rblaze/mbed-turret/board/turret.kicad_pcb

## KiCad design board/turret.kicad_pcb (2022-04-12)

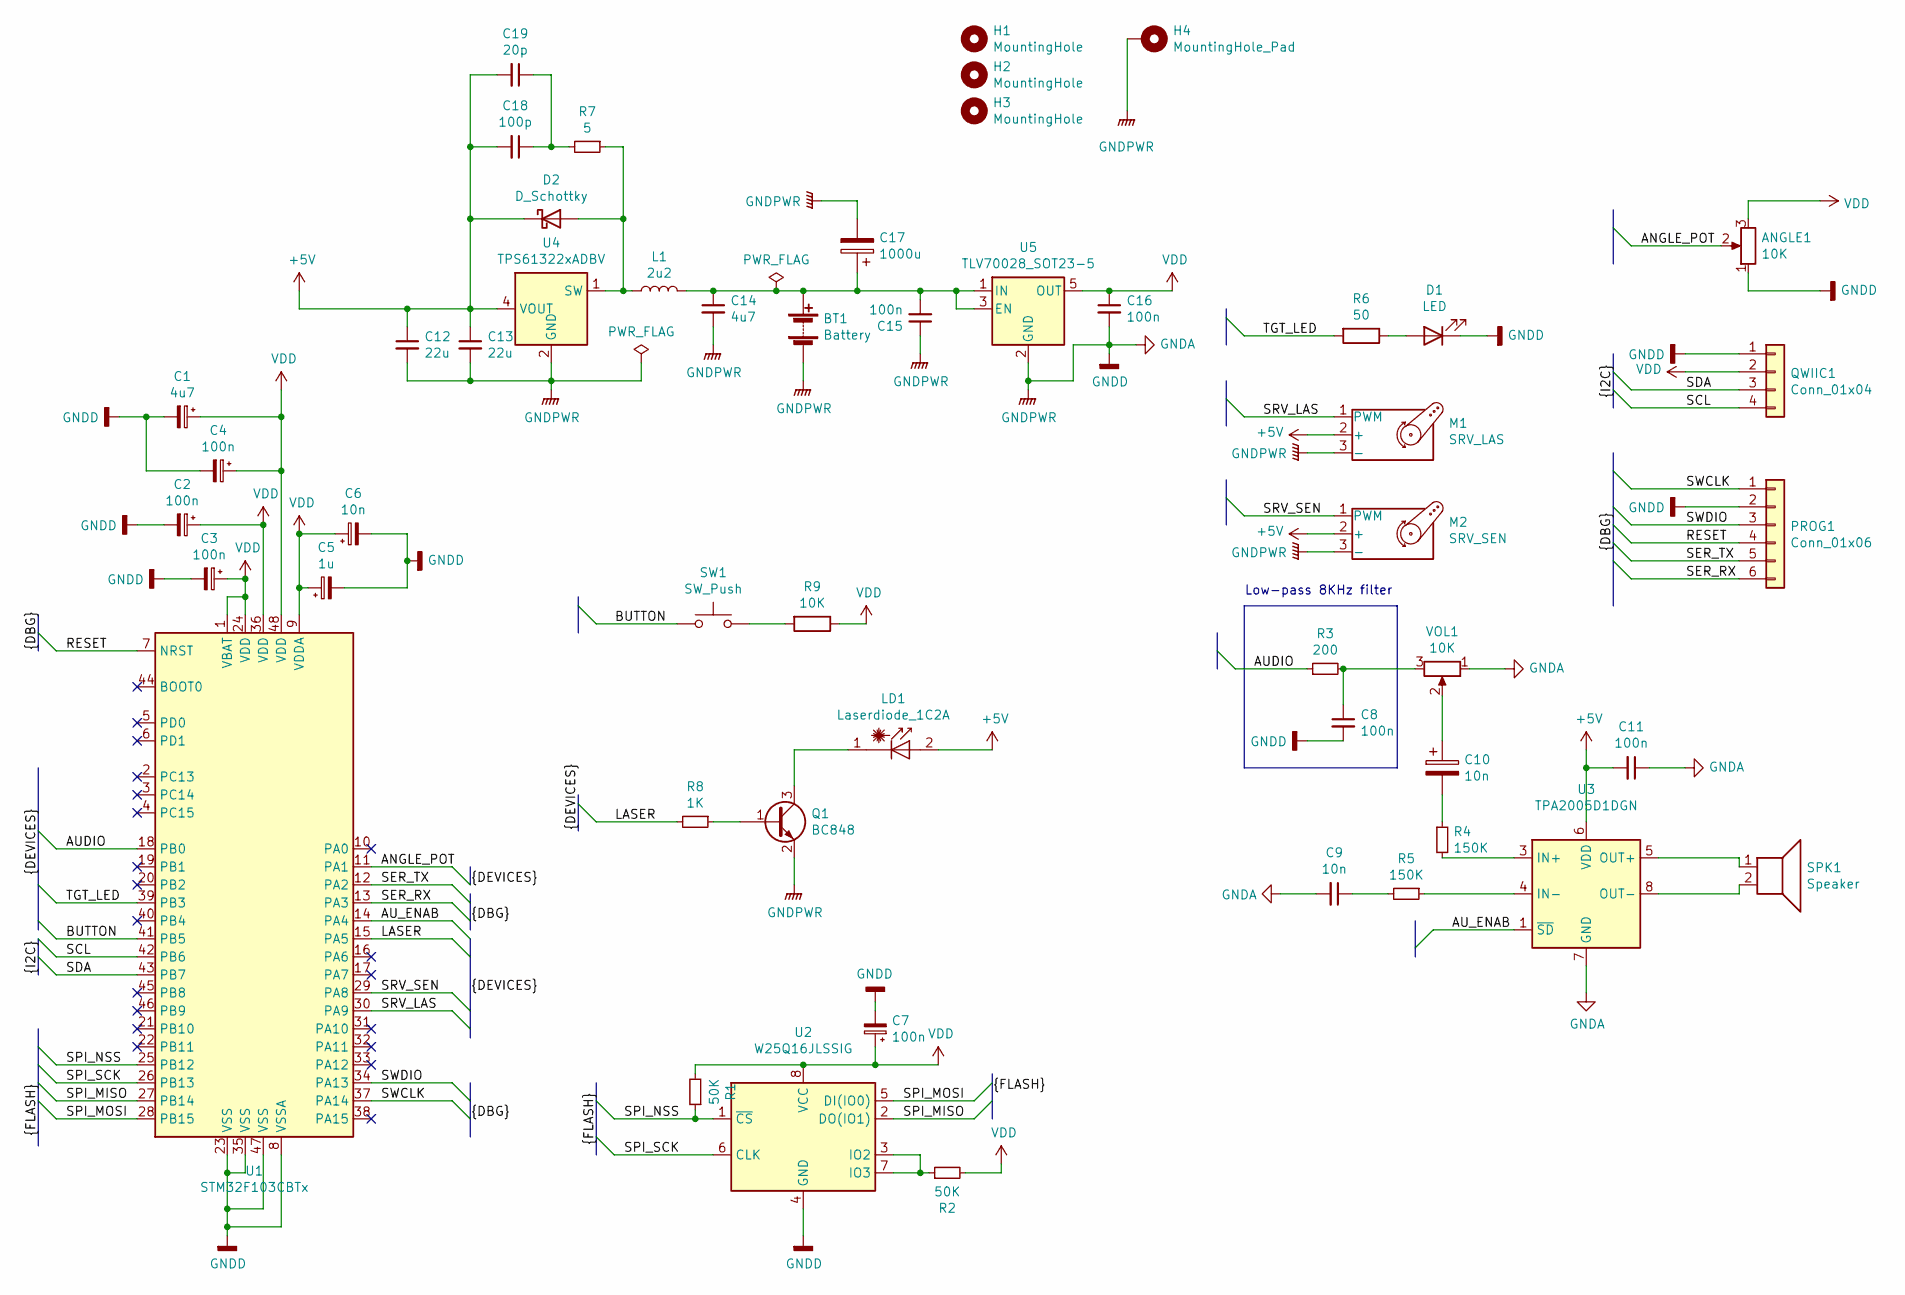
[picture p1: schematic turret.kicad_sch]

Parts:
ANGLE1: 10K; Molex_KK-254_AE-6410-03A_1x03_P2.54mm_Vertical
BT1: Battery; Molex_KK-254_AE-6410-02A_1x02_P2.54mm_Vertical
C1, C14: 4u7; C_0402_1005Metric
C2, C3, C4, C7, C8, C11, C15, C16: 100n; C_0402_1005Metric
C5: 1u; C_0402_1005Metric
C6, C9, C10: 10n; C_0402_1005Metric
C12, C13: 22u; C_0603_1608Metric
C17: 1000u; CP_Radial_D10.0mm_P5.00mm
C18: 100p; C_0402_1005Metric
C19: 20p; C_0402_1005Metric
D1: LED; LED_0805_2012Metric
D2: D_Schottky; D_SOD-323
H1, H2, H3: MountingHole; JLCPCB_Tooling_Hole
H4: MountingHole_Pad; MountingHole_2.2mm_M2_DIN965_Pad
L1: 2u2; L_1008_2520Metric
LD1: Laserdiode_1C2A; Molex_KK-254_AE-6410-02A_1x02_P2.54mm_Vertical
M1: SRV_LAS; Molex_KK-254_AE-6410-03A_1x03_P2.54mm_Vertical
M2: SRV_SEN; Molex_KK-254_AE-6410-03A_1x03_P2.54mm_Vertical
PROG1: Conn_01x06; Molex_SPOX_5267-06A_1x06_P2.50mm_Vertical
Q1: BC848; SOT-23
QWIIC1: Conn_01x04; JST_SH_BM04B-SRSS-TB_1x04-1MP_P1.00mm_Vertical
R1, R2: 50K; R_0402_1005Metric
R3: 200; R_0402_1005Metric
R4, R5: 150K; R_0402_1005Metric
R6: 50; R_0402_1005Metric
R7: 5; R_0402_1005Metric
R8: 1K; R_0402_1005Metric
R9: 10K; R_0402_1005Metric
SPK1: Speaker; Molex_KK-254_AE-6410-02A_1x02_P2.54mm_Vertical
SW1: SW_Push; SW_SPST_PTS810
U1: STM32F103CBTx; LQFP-48_7x7mm_P0.5mm
U2: W25Q16JLSSIG; SOIC-8_5.23x5.23mm_P1.27mm
U3: TPA2005D1DGN; TI_VSSOP-PowerPAD-8_3.0x3.0mm_P0.65mm_ThermalVias
U4: TPS61322xADBV; SOT-23-5
U5: TLV70028_SOT23-5; SOT-23-5
VOL1: 10K; Molex_KK-254_AE-6410-03A_1x03_P2.54mm_Vertical

Connections:
+5V: C11.2, C12.1, C13.1, C18.2, C19.2, D2.1 (K), LD1.2 (A), M1.2 (+), M2.2 (+), U3.6 (VDD), U4.3 (NC), U4.4 (VOUT)
/ANGLE_POT: ANGLE1.2, U1.11 (PA1)
/AUDIO: R3.1, U1.18 (PB0)
/AU_ENAB: U1.14 (PA4), U3.1 (~SD)
/BUTTON: SW1.1, U1.41 (PB5)
/LASER: R8.2, U1.15 (PA5)
/RESET: PROG1.4, U1.7 (NRST)
/SCL: QWIIC1.4, U1.42 (PB6)
/SDA: QWIIC1.3, U1.43 (PB7)
/SER_RX: PROG1.6, U1.13 (PA3)
/SER_TX: PROG1.5, U1.12 (PA2)
/SPI_MISO: U1.27 (PB14), U2.2 (DO(IO1))
/SPI_MOSI: U1.28 (PB15), U2.5 (DI(IO0))
/SPI_NSS: R1.1, U1.25 (PB12), U2.1 (~CS)
/SPI_SCK: U1.26 (PB13), U2.6 (CLK)
/SRV_LAS: M1.1 (PWM), U1.30 (PA9)
/SRV_SEN: M2.1 (PWM), U1.29 (PA8)
/SWCLK: PROG1.1, U1.37 (PA14)
/SWDIO: PROG1.3, U1.34 (PA13)
/TGT_LED: R6.2, U1.39 (PB3)
GNDA: ANGLE1.1, BT1.2 (-), C1.2, C2.2, C3.2, C4.2, C5.2, C6.2, C7.2, C8.2, C9.2, C11.1, C12.2, C13.2, C14.2, C15.1, C16.2, C17.2, D1.1 (K), H4.1, M1.3 (-), M2.3 (-), PROG1.2, Q1.2 (E), QWIIC1.1, U1.8 (VSSA), U1.23 (VSS), U1.35 (VSS), U1.47 (VSS), U2.4 (GND), U3.7 (GND), U3.9, U4.2 (GND), U4.5 (NC), U5.2 (GND), U5.4 (NC), VOL1.1
unnamed: BT1.1 (+), C14.1, C15.2, C17.1, L1.2, U5.1 (IN), U5.3 (EN)
unnamed: C8.1, R3.2, VOL1.3
unnamed: C9.1, R5.2
unnamed: C10.1, VOL1.2
unnamed: C10.2, R4.1
unnamed: C18.1, C19.1, R7.2
unnamed: D1.2 (A), R6.1
unnamed: D2.2 (A), L1.1, R7.1, U4.1 (SW)
unnamed: LD1.1 (K), Q1.3 (C)
unnamed: Q1.1 (B), R8.1
unnamed: R2.1, U2.3 (IO2), U2.7 (IO3)
unnamed: R4.2, U3.3 (IN+)
unnamed: R5.1, U3.4 (IN-)
unnamed: R9.2, SW1.2
unnamed: SPK1.1, U3.5 (OUT+)
unnamed: SPK1.2, U3.8 (OUT-)
VDD: ANGLE1.3, C1.1, C2.1, C3.1, C4.1, C5.1, C6.1, C7.1, C16.1, QWIIC1.2, R1.2, R2.2, R9.1, U1.1 (VBAT), U1.9 (VDDA), U1.24 (VDD), U1.36 (VDD), U1.48 (VDD), U2.8 (VCC), U5.5 (OUT)

Notes on the sheet:
Low-pass 8KHz filter

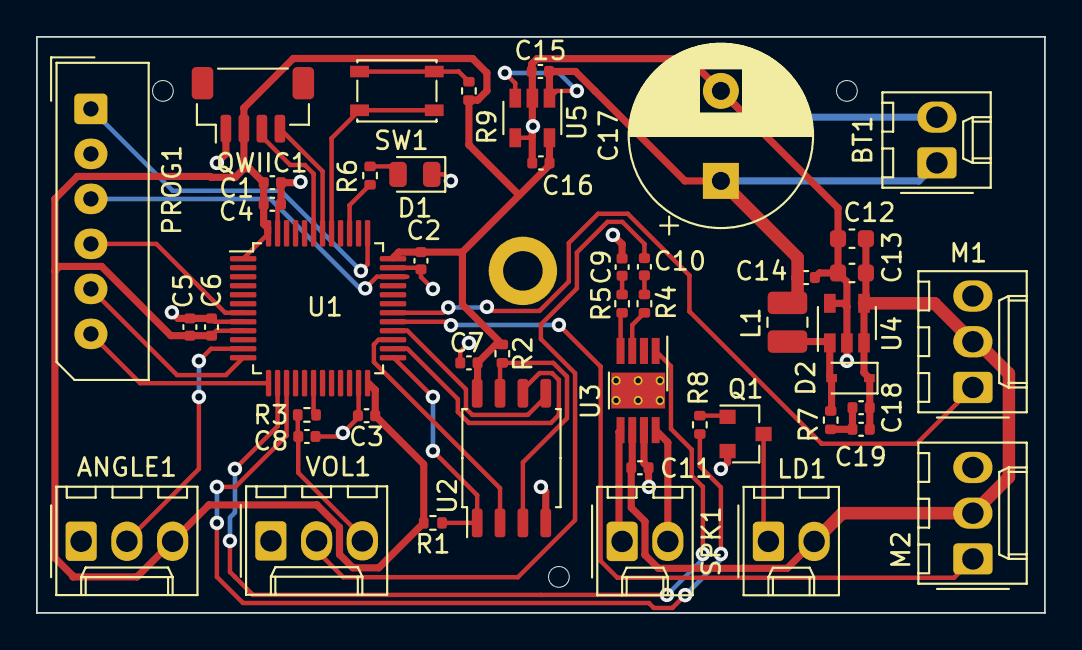
[picture p2: board turret.kicad_pcb from above]

Board: 2 copper layers, 56.0 x 32.0 mm, 51 parts (0 on the bottom side), 38 nets.
