rblaze/mbed-turret/board/board.ioc

Mcu.UserName=STM32F103RBTx
PA1.GPIO_Label=PA1 [Angle setting]
PA1.Signal=ADCx_IN1
PA13.Signal=SYS_JTMS-SWDIO
PA14.Signal=SYS_JTCK-SWCLK
PA2.Signal=USART2_TX
PA3.Signal=USART2_RX
PA4.GPIO_Label=PA4 [Audio Disable]
PA4.Signal=GPIO_Output
PA5.GPIO_Label=PA5 [Laser]
PA5.Signal=GPIO_Output
PA8.GPIO_Label=PA8 [Servo PWM]
PA8.Signal=S_TIM1_CH1
PA9.GPIO_Label=PA9 [Laser PWM]
PA9.Signal=S_TIM1_CH2
PB0.GPIO_Label=PB0 [Audio]
PB0.Signal=S_TIM3_CH3
PB12.Signal=SPI2_NSS
PB13.Signal=SPI2_SCK
PB14.Signal=SPI2_MISO
PB15.Signal=SPI2_MOSI
PB3.GPIO_Label=PB3 [Contact]
PB3.Signal=GPIO_Output
PB5.GPIO_Label=PB5 [Button]
PB5.Signal=GPIO_Input
PB6.Signal=I2C1_SCL
PB7.Signal=I2C1_SDA
