rblaze/mbed-turret/(commit log)

2019-11-25 Add servo range adjustment
2019-12-24 Ranging calibration
2019-12-25 Add laser targeting
2019-12-28 Reset PRNG using calibration time.
    [Ranging.cpp]
2019-12-29 Use calibration pot to init RNG.
2020-06-09 Update sensor library
2020-06-09 Update board config
2020-12-20 Add board design
    [turret.kicad_pcb, turret.sch]
2021-01-18 Add MCU to board
    [turret.sch]
2021-01-18 Add audio amplifier
    [turret.sch]
2021-01-19 Add servos
    [turret.sch]
2021-01-19 Add rest of parts except power
    [turret.sch]
2021-01-20 Assign most components
    [turret.kicad_pcb, turret.sch]
2021-02-01 Relocate components to tested pins
    [turret.sch]
2021-02-01 Switch to DMA-based audio player
2021-02-05 Fix pin assignment
    [turret.sch]
2021-02-12 Add 5V boost
    [turret.sch]
2021-02-12 Move LEDs to higher-powered pins
2021-02-12 Add 2V8 regulator
    [turret.sch]
2021-03-02 Add PCB design
    [turret.kicad_pcb, turret.sch]
2021-03-05 Reroute 3v3 power
    [turret.kicad_pcb]
2021-03-06 Add mounting holes
    [turret.kicad_pcb, turret.sch]
2021-04-15 Partial routing
    [turret.kicad_pcb, turret.sch]
2021-04-16 Add tooling holes
    [turret.kicad_pcb, turret.sch]
2022-03-31 Update to kicad 6
    [turret.kicad_pcb, turret.kicad_sch, turret.sch]
2022-04-08 Board layout complete
    [turret.kicad_pcb, turret.kicad_sch]
2022-04-11 Fix silkscreen overlaps
    [turret.kicad_pcb]
2022-04-12 Adjust component clearances for assembly
    [turret.kicad_pcb]
2022-04-12 Update plot settings
    [turret.kicad_pcb]
